tbenzi/WordClock/doc/wordclock.docx

| IT IS | | | | HALF | | | | TEN
| QUARTER | | | | | | TWENTY
| FIVE | | | | MINUTES | | | | TO
| PAST | | | | ONE | | | | THREE
| TWO | | | | FOUR | | | | FIVE
| SIX | | | | SEVEN | | | | EIGHT
| NINE | | | | TEN | | | | ELEVEN
| TWELVE | | | | O’CLOCK | | | | | | DST
| AM | | • | | • | | • | | • | | PM

| IT IS | | | | HALF | | | | TEN
| QUARTER | | | | | | TWENTY
| FIVE | | | | MINUTES | | | | TO
| PAST | | | | ONE | | | | THREE
| TWO | | | | FOUR | | | | FIVE
| SIX | | | | SEVEN | | | | EIGHT
| NINE | | | | TEN | | | | ELEVEN
| TWELVE | | | | O’CLOCK | | | | | | DST
| AM | | • | | • | | • | | • | | PM

IT IS | | | A | HALF | | | A | TEN
F
QUARTER | | | | | E | TWENTY
F
FIVE | | | B | MINUTES | | | C | TO
G
PAST | | | | ONE | | | | THREE
G
TWO | | | | FOUR | | | | FIVE
G
SIX | | | | SEVEN | | | | EIGHT
G
NINE | | | | TEN | | | | ELEVEN
H
TWELVE | | | | O’CLOCK | | | | | D | DST
I
AM | A | • | | • | A | • | A | • | | PM

Orizzontali

2 x F + 4 x G + H + I = 8 da 31 mm x 6 + 5 mm x 5 = 211 mm

Verticali

6 x A = 22 mm + 5 mm = 6 da 27 mm

1 x B = 22 mm x 7 + 5 mm x 7 = 1 da 189 mm

1 x C = 22 mm x 5 + 5 mm x 6 = 1 da 140 mm

1 x D = 22 mm x 2 + 5 mm x 2 = 1 da 54 mm

1 x E = 22 mm + 5 mm x 2 = 1 da 32 mm

211
67 | | | 5 | 31 | 5 | 31 | 5 | 67
2x
F

67 | | | 5 | 67 | | | 5 | 67
4x
G

67 | | | 5 | 67 | | | 5 | 31 | 5 | 31
1x
H

31 | 5 | 31 | 5 | 31 | 5 | 31 | 5 | 31 | 5 | 31
1x
I

| | | | | 140 | 5
27 | 22 | 5x | A | | | 22 | 1x | C | | 189 | 22 | 1x | B
| 5 | | | | | 5 | | | | | 5
| | | | | | 22 | | | | | 22
| | | | | | 5 | | | | | 5
54 | 22 | 1x | D | | | 22 | | | | | 22
| 5 | | | | | 5 | | | | | 5
| 22 | | | | | 22 | | | | | 22
| 5 | | | | | 5 | | | | | 5
| | | | | | 22 | | | | | 22
32 | 5 | | | | | 5 | | | | | 5
| 22 | 1x | E | | | | | | | | 22
| 5 | | | | | | | | | | 5
| | | | | | | | | | | 22
| | | | | | | | | | | 5

Pareti superiore (U) inferiore (D)

2 da 253 mm x 10 mm x 100 mm

U

U | 1A | | | | | | | | | | 2A
| ↑ | | | | | | | | | | ↑
| 1B | | | | | | | | | | 2B

D

| 3A | | | | | | | | | | 4A
D | ↑ | | | | | | | | | | ↑
| 3B | | | | | | | | | | 4B

Pareti laterali destra (R) sinistra (L)

2 da 221 mm x 10 mm x 100 mm

| | | | | L | | R
1B | | → | 1A | | | | | | 2A | ← | | 2B
3B | | → | 3A | | | | | | 4A | ← | | 4B

Sotto la griglia e sul fondo un rettangolo 211 mm x 243 mm x 5 mm
