tbenzi/WordClock/(commit log)

2017-12-04 No compilation errors but it does not work yet
    [NewWordClockDST.ino]
2018-05-18 Add single step Test led
